MissouriMRDT/Power_Management_Hardware/README.md

# Power_Management_Hardware
Monitors health of the battery and distributes power to the rover's electronics
