MissouriMRDT/Power_Management_Hardware/Hardware/PMS_2024/PMS/PMS.kicad_pcb

## KiCad design Hardware/PMS_2024/PMS/PMS.kicad_pcb (2024-04-03)

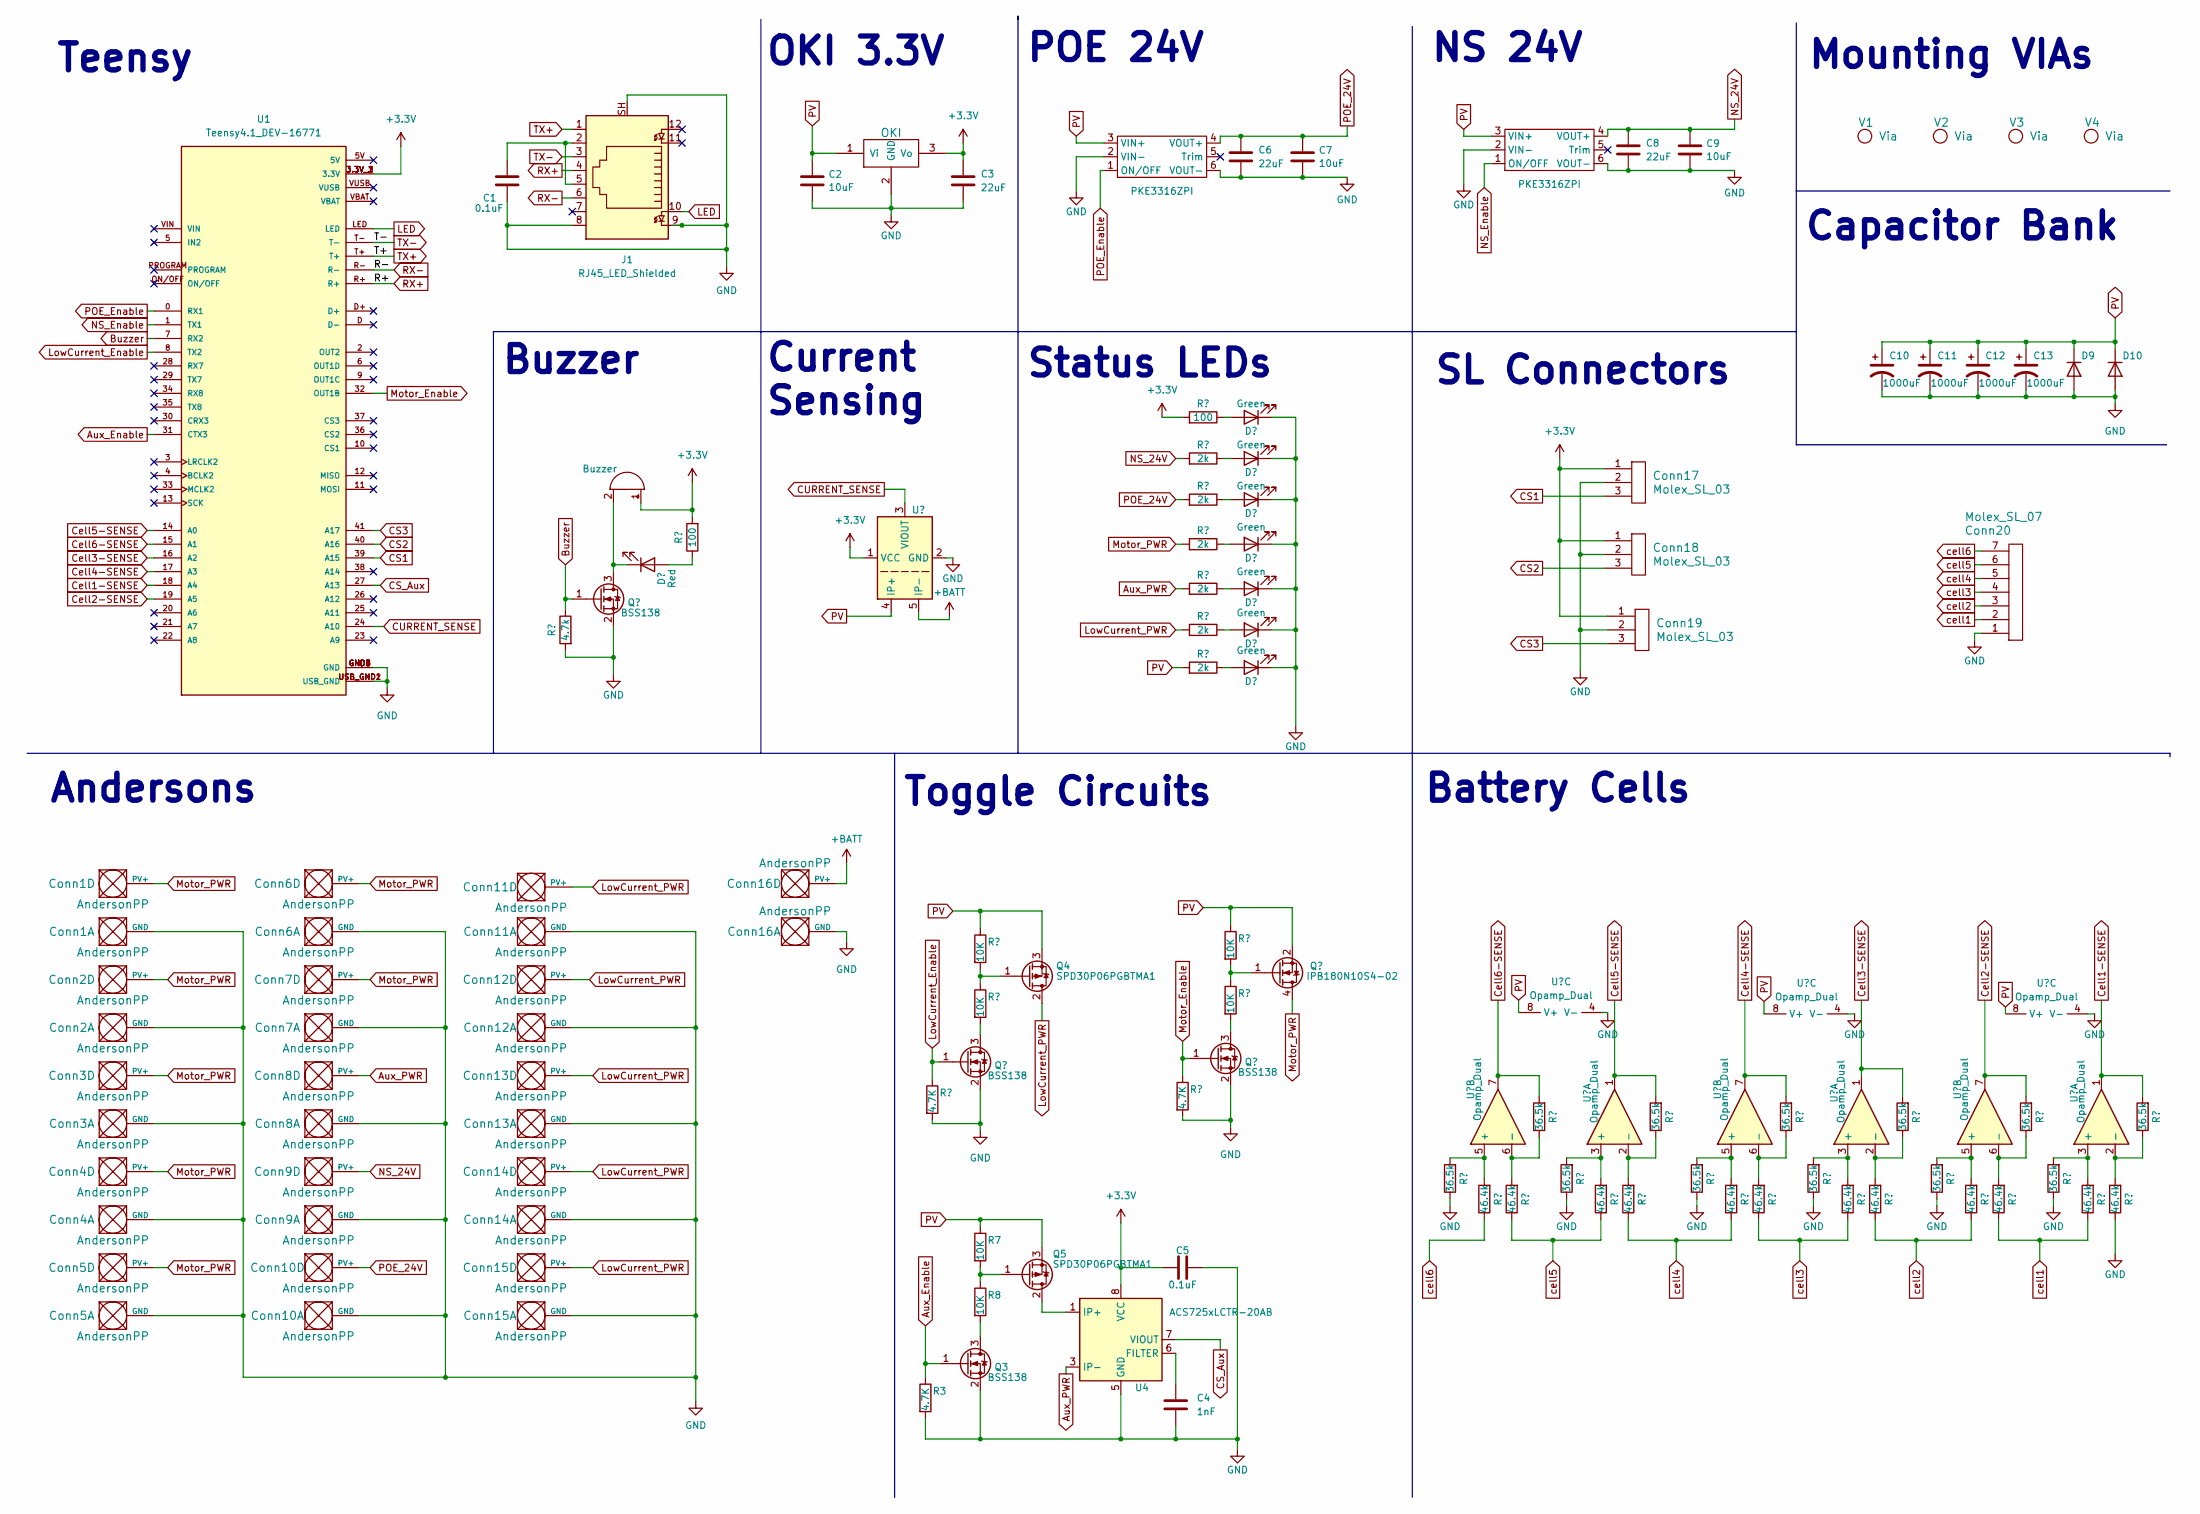
[picture p1: schematic PMS.kicad_sch]

Parts:
BZ1: Buzzer; Buzzer_12x9.5RM7.6
C1, C5: 0.1uF; C_0603_1608Metric_Pad1.08x0.95mm_HandSolder
C2, C7, C9: 10uF; C_1206_3216Metric_Pad1.33x1.80mm_HandSolder
C3: 22uF; C_0603_1608Metric_Pad1.08x0.95mm_HandSolder
C4: 1nF; C_0603_1608Metric_Pad1.08x0.95mm_HandSolder
C6, C8: 22uF; CP_Radial_D5.0mm_P2.00mm
C10, C11, C12, C13: 1000uF; CP_Radial_D16.0mm_P7.50mm
Conn1, Conn2, Conn3, Conn4, Conn5, Conn6, Conn7, Conn8, Conn9, Conn10, Conn11, Conn12, Conn13, Conn14, Conn15: AndersonPP; Square_Anderson_2_H_Stacked
Conn16: AndersonPP; Square_Anderson_2_H_Side_By_Side_PV
Conn17, Conn18, Conn19: Molex_SL_03; MOLEX_SL_03_Horizontal
Conn20: Molex_SL_07; MOLEX_SL_07_Horizontal
D1: Red; LED_0603_1608Metric_Pad1.05x0.95mm_HandSolder
D2, D3, D4, D5, D6, D7, D8: Green; LED_0603_1608Metric_Pad1.05x0.95mm_HandSolder
D9, D10: 1.5KE36A+; D_DO-201_P5.08mm_Vertical_KathodeUp
J1: RJ45_LED_Shielded; RJ45_Teensy
Q1, Q2, Q3, Q6: BSS138; SOT-23
Q4, Q5: SPD30P06PGBTMA1; TO-252-2
Q7: IPB180N10S4-02; TO-263-6
R1: 4.7k; R_0603_1608Metric_Pad0.98x0.95mm_HandSolder
R2, R10: 100; R_0603_1608Metric_Pad0.98x0.95mm_HandSolder
R3, R4, R9: 4.7K; R_0603_1608Metric_Pad0.98x0.95mm_HandSolder
R5, R6, R7, R8, R17, R18: 10K; R_0603_1608Metric_Pad0.98x0.95mm_HandSolder
R11, R12, R13, R14, R15, R16: 2k; R_0603_1608Metric_Pad0.98x0.95mm_HandSolder
R19, R22, R23, R26, R27, R30, R31, R34, R35, R38, R39, R42: 36.5k; R_0603_1608Metric_Pad0.98x0.95mm_HandSolder
R20, R21, R24, R25, R28, R29, R32, R33, R36, R37, R40, R41: 46.4k; R_0603_1608Metric_Pad0.98x0.95mm_HandSolder
U1: Teensy4.1_DEV-16771; Teensy_4_1_Ethernet; PARTREV 4.1
U2: OKI; OKI_Horizontal
U3: ACS758xCB-200B-PFF; Allegro_CB_PFF
U4: ACS725xLCTR-20AB; SOIC-8_3.9x4.9mm_P1.27mm
U5, U7: PKE3316ZPI
U6, U8, U9: Opamp_Dual; SO-8_3.9x4.9mm_P1.27mm
V1, V2, V3, V4: Via; 4_40_Hole

Connections:
+3.3V: BZ1.1 (-), C3.1, C5.1, Conn17.1, Conn18.1, Conn19.1, R2.2, R10.2, U1.3.3V_1 (3.3V), U1.3.3V_2 (3.3V), U1.3.3V_3 (3.3V), U2.3 (Vo), U3.1 (VCC), U4.8 (VCC)
+BATT: Conn16.4 (PV+), U3.5 (IP-)
Aux_Enable: Q3.1 (G), R3.1, U1.31 (CTX3)
Aux_PWR: Conn8.4 (PV+), R14.2, U4.3 (IP-), U4.4 (IP-)
Buzzer: Q1.1 (G), R1.1, U1.7 (RX2)
CS1: Conn17.3, U1.39 (A15)
CS2: Conn18.3, U1.40 (A16)
CS3: Conn19.3, U1.41 (A17)
CS_Aux: U1.27 (A13), U4.7 (VIOUT)
CURRENT_SENSE: U1.24 (A10), U3.3 (VIOUT)
Cell1-SENSE: R42.2, U1.18 (A4), U9.1
Cell2-SENSE: R38.2, U1.19 (A5), U9.7
Cell3-SENSE: R34.2, U1.16 (A2), U8.1
Cell4-SENSE: R30.2, U1.17 (A3), U8.7
Cell5-SENSE: R26.2, U1.14 (A0), U6.1
Cell6-SENSE: R22.2, U1.15 (A1), U6.7
GND: C1.1, C2.2, C3.2, C4.1, C5.2, C6.2, C7.2, C8.2, C9.2, C10.2, C11.2, C12.2, C13.2, Conn1.1 (GND), Conn2.1 (GND), Conn3.1 (GND), Conn4.1 (GND), Conn5.1 (GND), Conn6.1 (GND), Conn7.1 (GND), Conn8.1 (GND), Conn9.1 (GND), Conn10.1 (GND), Conn11.1 (GND), Conn12.1 (GND), Conn13.1 (GND), Conn14.1 (GND), Conn15.1 (GND), Conn16.1 (GND), Conn17.2, Conn18.2, Conn19.2, Conn20.1, D2.1 (K), D3.1 (K), D4.1 (K), D5.1 (K), D6.1 (K), D7.1 (K), D8.1 (K), D9.2 (A), D10.2 (A), J1.8, J1.9, J1.SH, Q1.2 (S), Q2.2 (S), Q3.2 (S), Q6.2 (S), R1.2, R3.2, R4.2, R9.2, R19.1, R23.1, R27.1, R31.1, R35.1, R39.1, R41.1, U1.GND1 (GND), U1.GND2 (GND), U1.GND3 (GND), U1.GND4 (GND), U1.GND5 (GND), U1.USB_GND1 (USB_GND), U1.USB_GND2 (USB_GND), U2.2 (GND), U3.2 (GND), U4.5 (GND), U5.2 (VIN-), U5.6 (VOUT-), U6.4 (V-), U7.2 (VIN-), U7.6 (VOUT-), U8.4 (V-), U9.4 (V-)
LED: J1.10, U1.LED
LowCurrent_Enable: Q2.1 (G), R4.1, U1.8 (TX2)
LowCurrent_PWR: Conn11.4 (PV+), Conn12.4 (PV+), Conn13.4 (PV+), Conn14.4 (PV+), Conn15.4 (PV+), Q4.2 (D), R15.2
Motor_Enable: Q6.1 (G), R9.1, U1.32 (OUT1B)
Motor_PWR: Conn1.4 (PV+), Conn2.4 (PV+), Conn3.4 (PV+), Conn4.4 (PV+), Conn5.4 (PV+), Conn6.4 (PV+), Conn7.4 (PV+), Q7.4 (D), R13.2
NS_24V: C8.1, C9.1, Conn9.4 (PV+), R11.2, U7.4 (VOUT+)
NS_Enable: U1.1 (TX1), U7.1 (ON/OFF)
unnamed: BZ1.2 (+), D1.1 (K), Q1.3 (D)
unnamed: C1.2, J1.2, J1.5
unnamed: D1.2 (A), R2.1
unnamed: D2.2 (A), R10.1
unnamed: D3.2 (A), R11.1
unnamed: D4.2 (A), R12.1
unnamed: D5.2 (A), R13.1
unnamed: D6.2 (A), R14.1
unnamed: D7.2 (A), R15.1
unnamed: D8.2 (A), R16.1
unnamed: Q2.3 (D), R6.2
unnamed: Q3.3 (D), R8.2
unnamed: Q4.1 (G), R5.2, R6.1
unnamed: Q5.2 (D), U4.1 (IP+), U4.2 (IP+)
unnamed: Q5.1 (G), R7.2, R8.1
unnamed: Q6.3 (D), R18.2
unnamed: Q7.1 (G), R17.2, R18.1
unnamed: C4.2, U4.6 (FILTER)
unnamed: R23.2, R24.2, U6.3 (+)
unnamed: R25.2, R26.1, U6.2 (-)
unnamed: R19.2, R20.2, U6.5 (+)
unnamed: R21.2, R22.1, U6.6 (-)
unnamed: R31.2, R32.2, U8.3 (+)
unnamed: R33.2, R34.1, U8.2 (-)
unnamed: R27.2, R28.2, U8.5 (+)
unnamed: R29.2, R30.1, U8.6 (-)
unnamed: R39.2, R40.2, U9.3 (+)
unnamed: R41.2, R42.1, U9.2 (-)
unnamed: R35.2, R36.2, U9.5 (+)
unnamed: R37.2, R38.1, U9.6 (-)
POE_24V: C6.1, C7.1, Conn10.4 (PV+), R12.2, U5.4 (VOUT+)
POE_Enable: U1.0 (RX1), U5.1 (ON/OFF)
PV: C2.1, C10.1, C11.1, C12.1, C13.1, D9.1 (K), D10.1 (K), Q4.3 (S), Q5.3 (S), Q7.2 (S), Q7.3 (S), Q7.5 (S), Q7.6 (S), Q7.7 (S), R5.1, R7.1, R16.2, R17.1, U2.1 (Vi), U3.4 (IP+), U5.3 (VIN+), U6.8 (V+), U7.3 (VIN+), U8.8 (V+), U9.8 (V+)
RX+: J1.4, U1.R+
RX-: J1.6, U1.R-
TX+: J1.1, U1.T+
TX-: J1.3, U1.T-
cell1: Conn20.2, R37.1, R40.1
cell2: Conn20.3, R33.1, R36.1
cell3: Conn20.4, R29.1, R32.1
cell4: Conn20.5, R25.1, R28.1
cell5: Conn20.6, R21.1, R24.1
cell6: Conn20.7, R20.1

Notes on the sheet:
Teensy
OKI 3.3V
NS 24V
SL Connectors
Mounting VIAs
Toggle Circuits
Current Sensing
Buzzer
Andersons
Status LEDs
Capacitor Bank
Battery Cells
POE 24V

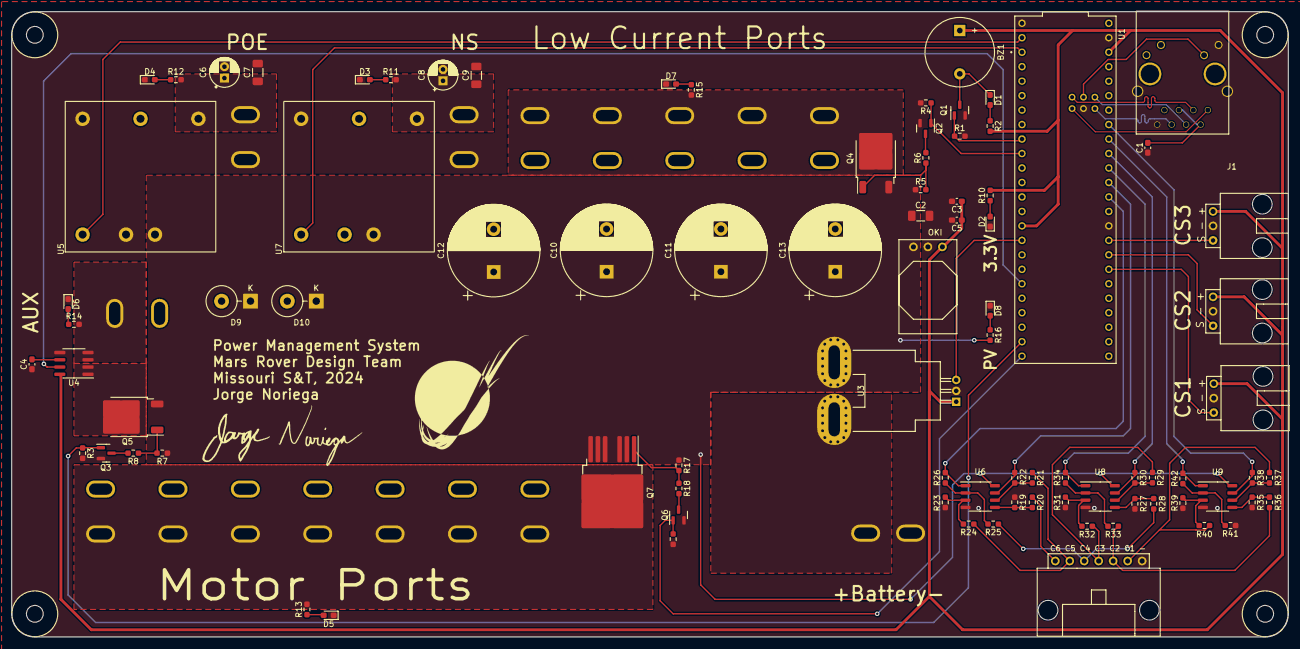
[picture p2: board PMS.kicad_pcb from above]

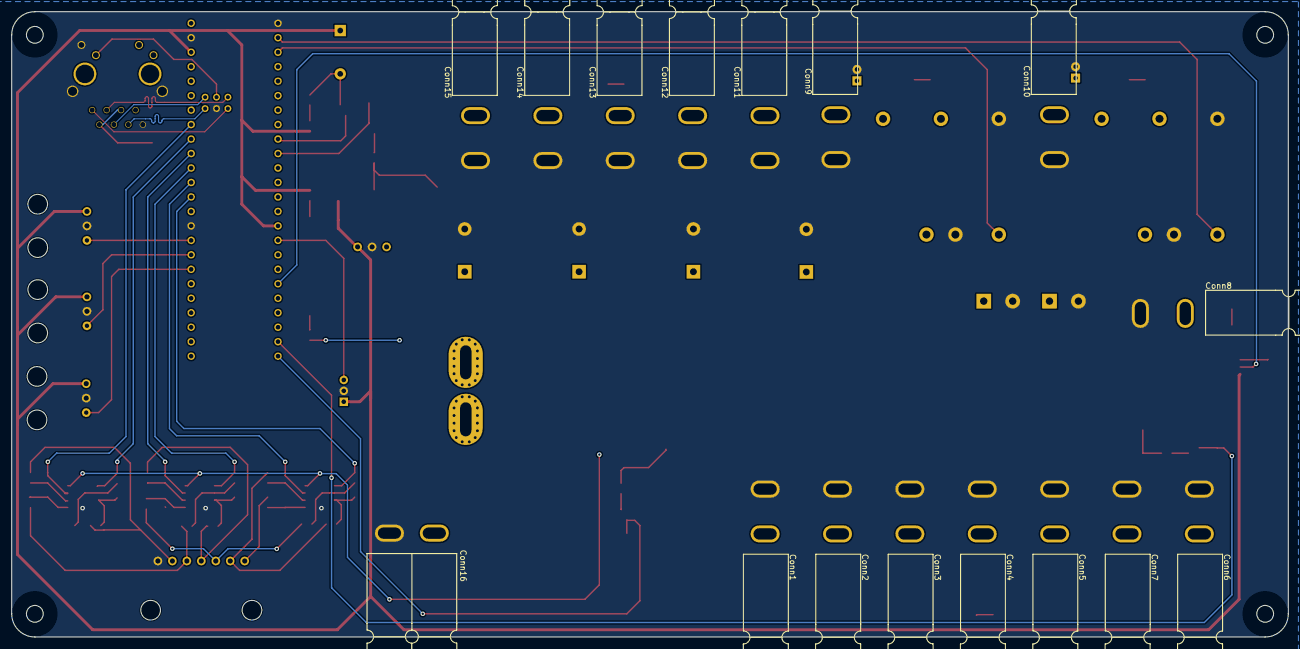
[picture p3: board PMS.kicad_pcb from below]

Board: 2 copper layers, 224.0 x 109.7 mm, 107 parts (16 on the bottom side), 67 nets.
