MissouriMRDT/Power_Management_Hardware/(commit log)

2024-03-01 Started PMS
    Started Schematic
    [PMS.kicad_pcb, PMS.kicad_sch]
2024-03-05 Layout Started
    [PMS.kicad_pcb, PMS.kicad_sch]
2024-03-07 Finished General Layout
    All trace work still needs to be done
    General layout is finished
    [PMS.kicad_pcb, PMS.kicad_sch]
2024-03-13 Changed Layout
    Changed the entire layout
    Most traces still need to be routed
    [PMS.kicad_pcb, PMS.kicad_sch]
2024-03-14 Finished Layout + Traces
    Finished Layout
    Silkscreens still need to be added
    [PMS.kicad_pcb, PMS.kicad_sch]
2024-03-18 Added Silkscreens
    Added Signature and Silkscreens
    [PMS.kicad_pcb]
2024-03-20 Layout Changes
    Added SL labels
    Moved some traces, away from planes
    [PMS.kicad_pcb]
2024-03-21 Resistor Changes
    Added a PV LED
    Changed some resistor values
    [PMS.csv, PMS.kicad_pcb, PMS.kicad_sch]
2024-03-21 Trace change
    Moved trace for a wider GND plane
    [PMS.kicad_pcb]
2024-03-24 Footprint Change
    [PMS.csv, PMS.kicad_pcb, PMS.kicad_sch]
2024-03-27 created gerbs
    [PMS-B_Cu.gbr, PMS-B_Mask.gbr, PMS-B_Paste.gbr, PMS-B_Silkscreen.gbr, PMS-Edge_Cuts.gbr, PMS-F_Cu.gbr, PMS-F_Mask.gbr, PMS-F_Paste.gbr]
2024-04-03 Created step file
    [PMS.kicad_pcb]
2024-04-13 Fixed ground plane to caps
    [PMS.kicad_pcb]
2024-04-13 Revert "Fixed ground plane to caps"
    This reverts commit 0f93090606acd132730fc91c24dbd6cd32ab7d8f.
    [PMS.kicad_pcb]
